jeonggubin/Industrial-Patrol-Robot-based-on-SLAM-and-CAN-Network/README.md

# Industrial Patrol Robot based on SLAM and CAN Network
SLAM 및 CAN 네트워크 기반 산업용 순찰 로봇

<table>
    <td align="center">
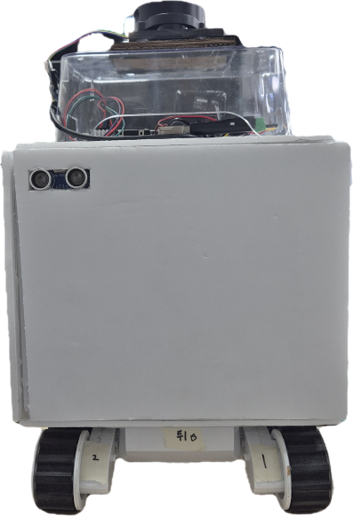
[picture p1: images/로봇후면부.png]
로봇 후면부
      
    </td>
    <td align="center">
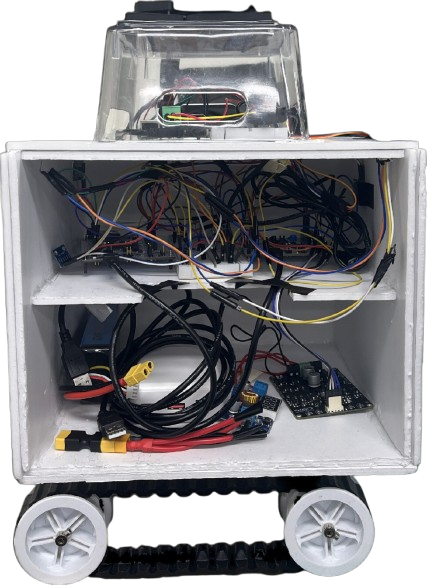
[picture p2: images/로봇내부.png]
로봇 내부
      
    </td>
    <td align="center">
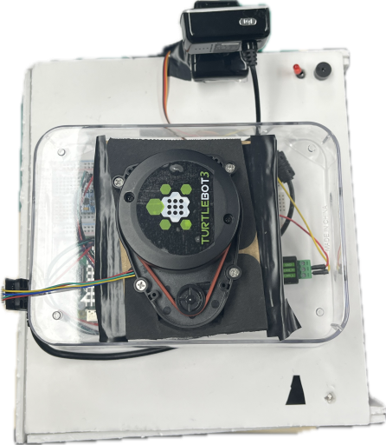
[picture p3: images/로봇상부.png]
로봇 상부
       
    </td>
  </tr>
</table>

## 🛰️ Industrial-Safety-Patrol-Mini-Project

### 🛠 개발 배경
<table>
  <tr>
    <td>
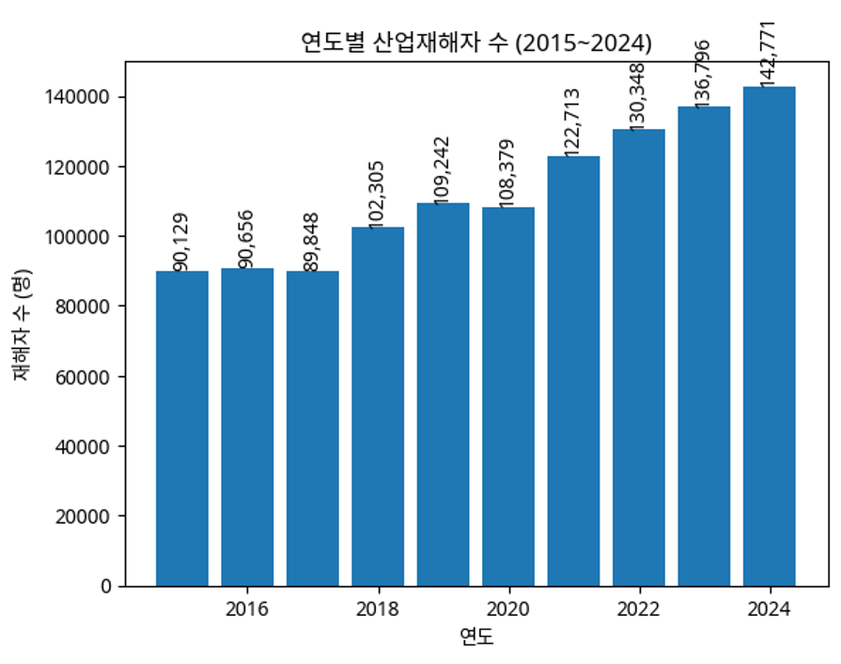
[picture p4: images/연도별 산업재해자 그래프.png]
연도별 산업재해자 그래프
      
    </td>
    <td>
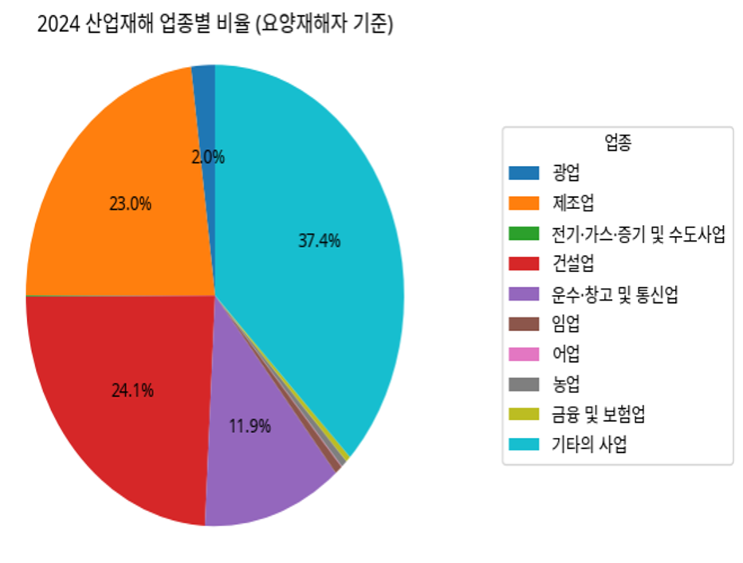
[picture p5: images/산업재해 업종별 비율 그래프.png]
산업재해 업종별 비율 그래프
      
    </td>
  </tr>
</table>

국가데이터처 ‘산업재해 현황분석’에 따르면 산업재해자 수는 매년 증가하는 추세이며, 특히 건설업과 제조업에서 높은 비율을 차지하는 것으로 나타났습니다.

이러한 산업 현장의 안전 문제와 인력 중심 현장 감시 체계의 한계를 해결하기 위해, LiDAR 기반 SLAM과 YOLOv5 비전 기술을 결합한 자율 순찰 로봇 시스템을 개발했습니다. 

본 프로젝트는 작업자의 안전장구 착용 여부를 실시간으로 감지하여 사고를 사전에 예방하고, 상시 감시 체계를 구축함으로써 현장 안전 관리의 효율성을 극대화하는 것을 목표로 합니다.

---

## 📅 프로젝트 개요
- **프로젝트 명:** SLAM 및 CAN 네트워크 기반 산업용 순찰 로봇
- **수행 기간:** 2026.02.25 ~ 2026.03.10
- **주요 기능**
  - **1:** LIDAR 기반 자율 순찰 및 SLAM
  - **2:** YOLOv5nu 기반 실시간 안전장비 탐지
  - **3:** CAN Bus 기반 분산 제어 시스템
  - **4:** 지능형 안전 정지 및 센서 데이터 필터링
  - **5:** 실시간 웹 통합 관제 대시보드
  - **6:** 자동 환경 반응 조명 및 경보 시스템

---

## 🛠 기술 스택
| 분류 | 기술 Stack |
| :--- | :--- |
| **Languages** | C, Python, JavaScript |
| **Communication** | CAN, RTSP, UDP, Socket.IO |
| **Frameworks** | ROS2 (Navi2, Cartographer, rf2o), YOLOv5nu, OpenCV, PyTorch, Node.js, MediaMTX |
| **Hardware/OS** | Raspberry Pi 5, STM32 (F446RE, F429ZI), USB-CAN 트랜시버(SN65HVD230), LiDAR(LD08), Webcam, IMU(MPU6050), Ubuntu 24.04, STM32CubeMX |

---

## 📂 디렉토리 구조
. <br>
├── 📂 **[ai_vision/](./ai_vision)** <br>
│&nbsp;&nbsp;&nbsp;└── AI 비전 기반 객체 인식 및 안전장비 착용 판별 코드 <br>
├── 📂 **[images/](./images)** <br>
│&nbsp;&nbsp;&nbsp;└── 🖼 <br>
├── 📂 **[main/](./main)** <br>
│&nbsp;&nbsp;&nbsp;└── 전체 시스템 실행 및 통합 제어 코드 <br>
├── 📂 **[slam/](./slam)** <br>
│&nbsp;&nbsp;&nbsp;└── SLAM 기반 지도 생성 및 위치 인식 관련 코드 <br>
├── 📂 **[stm32f429zi/](./stm32f429zi)** <br>
│&nbsp;&nbsp;&nbsp;└── STM32F429ZI 기반 펌웨어 프로젝트 <br>
├── 📂 **[stm32f446/](./stm32f446)** <br>
│&nbsp;&nbsp;&nbsp;└── STM32F446 기반 펌웨어 프로젝트 <br>
├── 📂 **[webDashBoard + sever/](./webDashBoard%20%2B%20sever)** <br>
│&nbsp;&nbsp;&nbsp;└── 웹 대시보드 및 서버 연동 코드 <br>
└── 📄 **[README.md](./README.md)** <br>

---

## 🧩 시스템 구성도 및 동작 흐름
- 시스템 구성도
<p align="center">
  <a href="./images/전체시스템구성도.png">
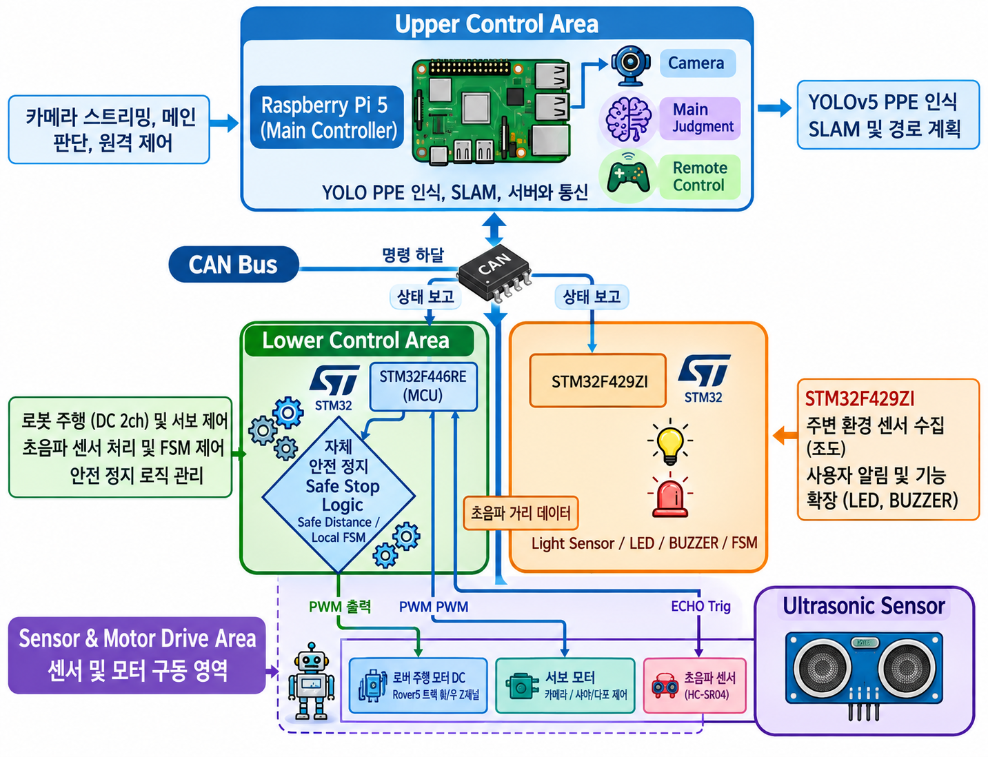
[picture p6: images/전체시스템구성도.png]
시스템 구성도
    
  </a>
</p>

- 전체 동작 흐름
```text
카메라 / LiDAR / 센서
        ↓
Raspberry Pi 5
- Vision AI
- SLAM
- 자율주행 판단
- 웹 서버
        ↓
CAN Network
        ↓
STM32 제어 노드
- 모터 제어
- 서보 제어
- 초음파 안전 정지
- LED / 부저 제어
        ↓
로버 주행 및 경고 동작
```

## 🔍 상세 기능 설명

### 1. 자율 주행 및 SLAM

로봇은 LiDAR 기반 SLAM을 이용해 작업장 지도를 생성하고, 자신의 위치를 추정하며 자율 주행을 수행합니다.

<table border="0">
  <tr>
    <td align="center">
      <a href="images/slam기반지도생성.png">
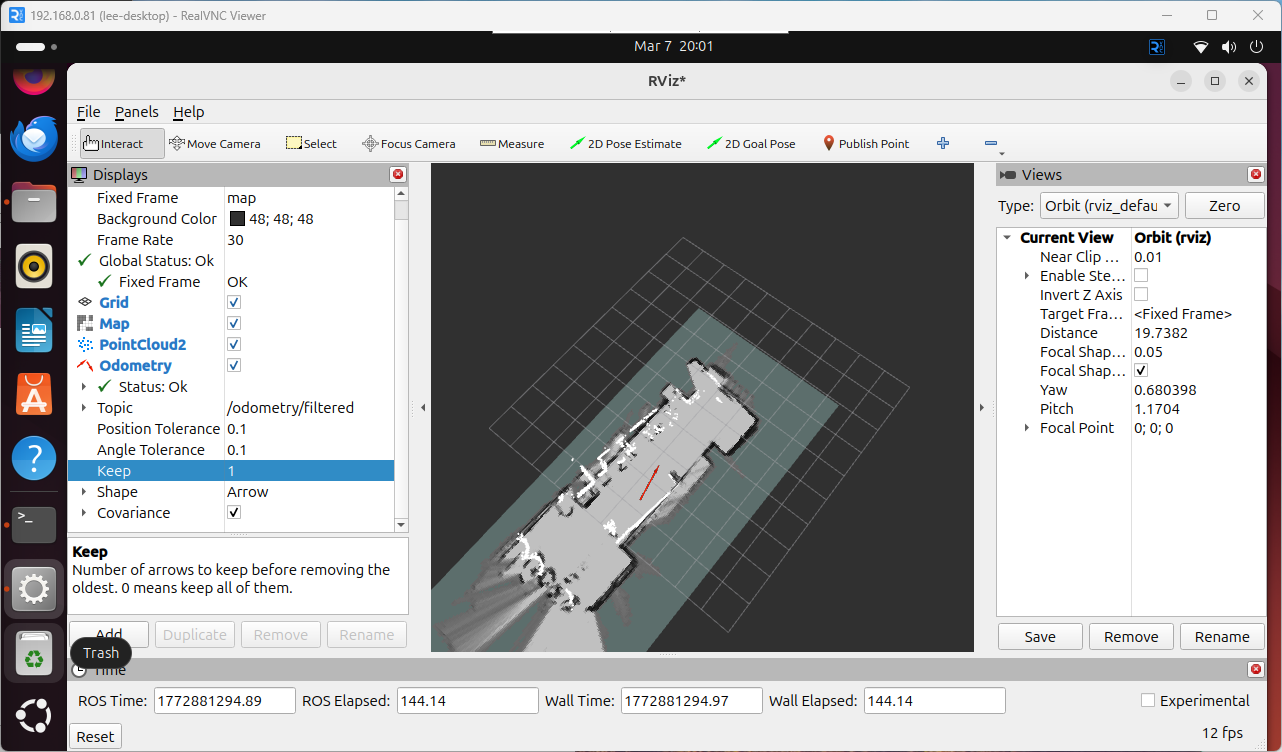
[picture p7: images/slam기반지도생성.png]
        
      </a>
    </td>
    <td align="center">
      <a href="images/자율주행_로봇+지도.png">
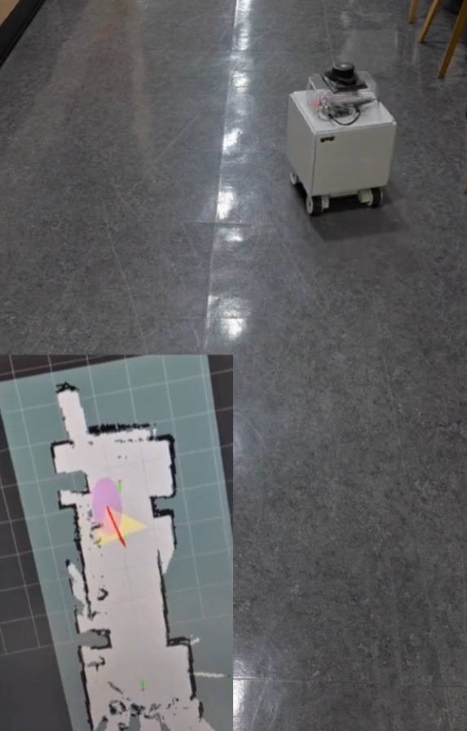
[picture p8: images/자율주행_로봇+지도.png]
        
      </a>
    </td>
    <td align="center">
      <a href="images/tftree.png">
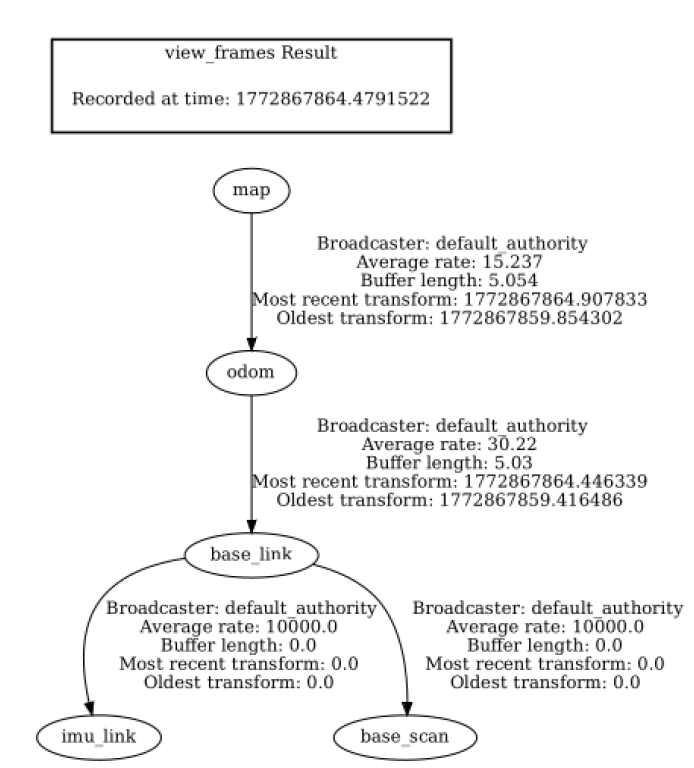
[picture p9: images/tftree.png]
        
      </a>
    </td>
  </tr>
</table>

- Cartographer SLAM 기반 지도 생성
- Nav2 기반 자율 주행
- LiDAR기반의 RF2O로 가상 오도메트리 생성
- IMU센서로 오도메트리를 보정하여 TF tree 구성 

### 2. Vision AI 안전 감지

Raspberry Pi 5에서 카메라 영상을 처리하고, YOLOv5nu 모델을 이용해 작업자를 인식합니다.  
안전모 또는 안전조끼 미착용이 감지되면 경고 신호를 제어부로 전달하여 모터를 정지시킵니다.

<div align="center">
  <video 
    src="https://github.com/user-attachments/assets/fe3a2b6f-3024-43d0-969e-007420c52cba" 
    width="80%" 
    autoplay 
    loop 
    muted 
    playsinline 
    preload="auto">
  </video>
  <p><i>실시간 안전 감지 및 CAN 통신 기반 모터 제어 시연</i></p>
</div>

<div align="center">
  <table border="0">
    <tr>
      <td align="center" style="border: none;">
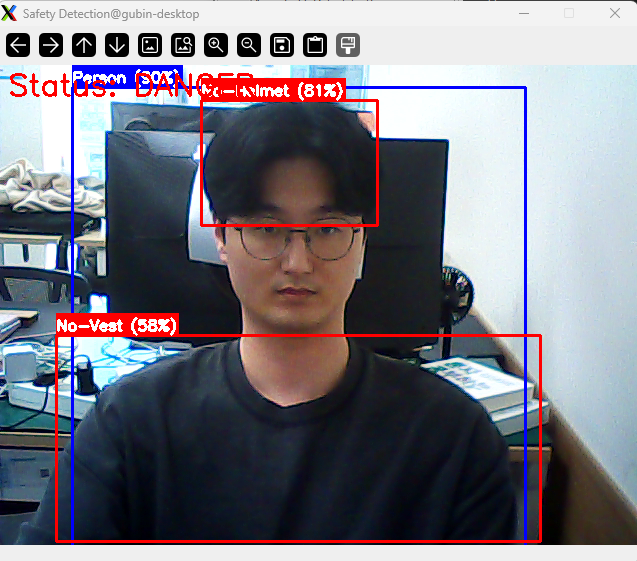
[picture p10: images/[DANGER] 모두 미착용.png]
[DANGER] 모두 미착용
        <br>
        <b>[DANGER] 모두 미착용</b>
      </td>
      <td align="center" style="border: none;">
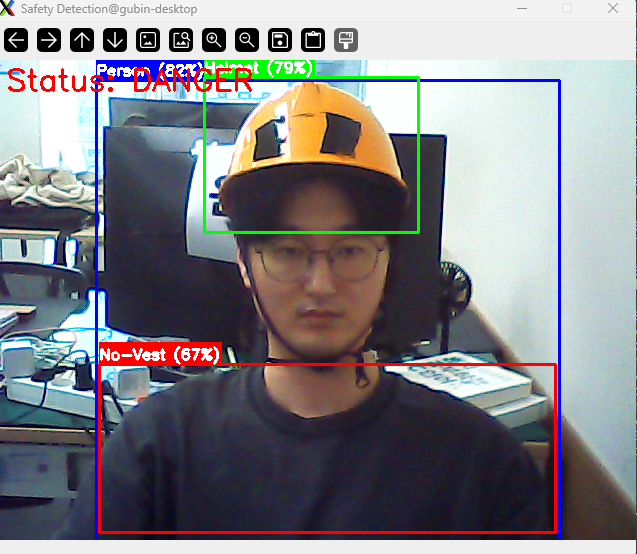
[picture p11: images/[DANGER] 안전모만 착용.png]
[DANGER] 안전모만 착용
        <br>
        <b>[DANGER] 안전모만 착용</b>
      </td>
    </tr>
    <tr>
      <td align="center" style="border: none;">
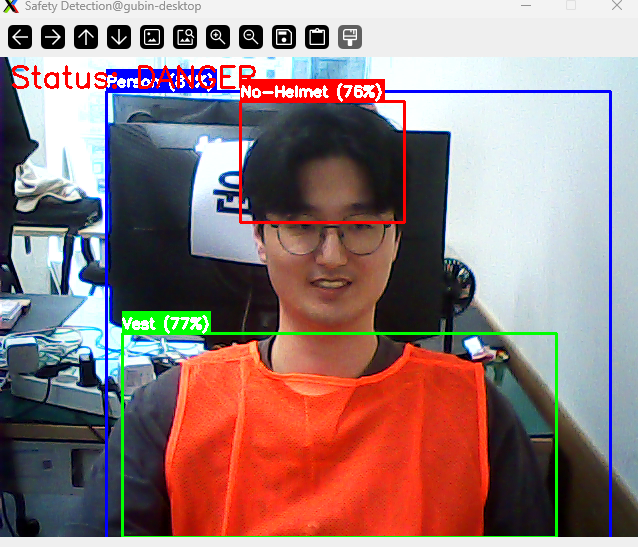
[picture p12: images/[DANGER] 안전조끼만 착용.png]
[DANGER] 안전조끼만 착용
        <br>
        <b>[DANGER] 안전조끼만 착용</b>
      </td>
      <td align="center" style="border: none;">
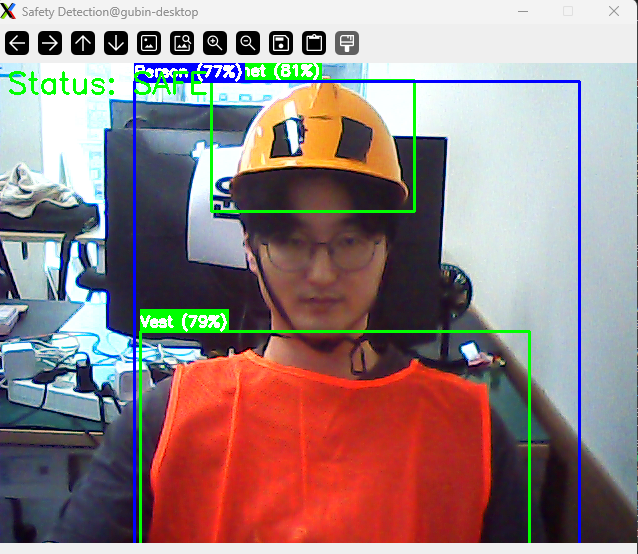
[picture p13: images/[SAFE] 모든 장비 착용.png]
[SAFE] 모든 장비 착용
        <br>
        <b>[SAFE] 모든 장비 착용</b>
      </td>
    </tr>
  </table>
</div>

### 3. CAN 기반 분산 제어 및 통신 프로토콜 📡

본 시스템은 **Raspberry Pi 5(메인 제어기)**와 **2대의 STM32 보드(하위 제어기)**를 단일 CAN 통신 버스로 연결하여 역할을 완벽히 분리하고 시스템 안정성을 높였습니다. 상위 제어기는 복잡한 연산과 네트워크를 담당하고, 하위 제어기는 실시간 하드웨어 제어를 전담합니다.

<p align="center">
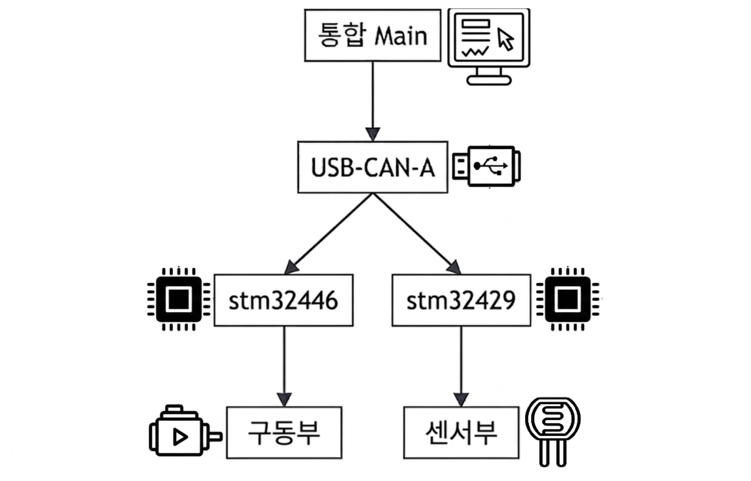
[picture p14: images/CAN_구성도.png]
CAN 네트워크 구성도
  
</p>

#### 🔹 노드별 주요 역할
| 노드 | 역할 | 상세 기능 |
|---|---|---|
| **Raspberry Pi 5** | **상위 통합 제어 및 AI** | - 자율주행 Nav2 제어 명령(`cmd_vel`)을 CAN 명령으로 변환 (`nav2_bridge`) <br>- Vision AI(YOLO) 객체 인식 및 위험 판별 <br>- WebSocket 기반 센서 데이터 웹 대시보드 송출 (`ws_client`) |
| **STM32F446RE** | **주행 및 구동계 제어** | - 좌/우 DC 모터 구동 및 카메라 서보 모터 제어 <br>- 초음파 센서 기반 긴급 제동(AEB) 독립 수행 |
| **STM32F429ZI** | **환경 센싱 및 시각적 알림** | - 조도 센서(Lux)를 통한 주변 밝기 감지 <br>- 상황별 RGB LED, 경고용 적색 LED, 부저 알림 제어 |

#### 📊 CAN 통신 메시지 ID 및 프로토콜 명세 (Data Frame)

각 노드 간의 데이터 동기화를 위해 **500kbps 속도의 CAN 분산 통신망**을 구축하였으며, 메시지 충돌을 방지하고 데이터 정밀도를 확보하기 위해 아래와 같이 데이터 ID 및 비트 패킹(Packing) 프로토콜을 독자적으로 설계하여 운영합니다.

<p align="center">
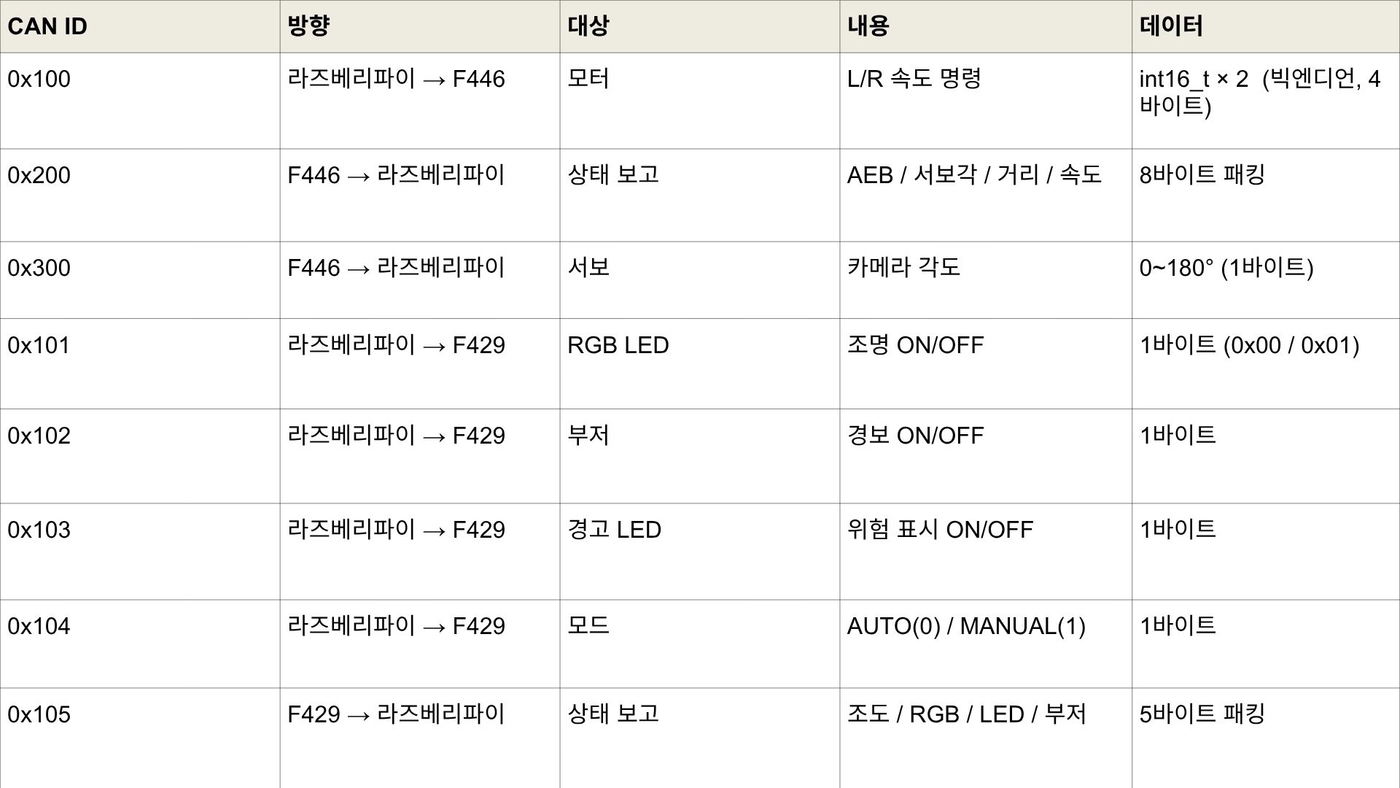
[picture p15: images/CAN 통신 메시지 ID 명세.jpg]
CAN 통신 프로토콜 명세
  
</p>

*   **모터 속도 명령 (ID: 0x100):** 데이터 왜곡 및 반전을 방지하기 위해 좌/우 속도 데이터를 int16_t 타입 2개 구조의 **빅엔디언(Big-Endian)** 방식으로 매핑하여 상위 제어기에서 주행 보드(F446)로 4바이트 전송합니다.

> ⚠️ **[이슈] CAN ID 중복 할당**
> 현재 설계 상 라즈베리파이가 STM32F446으로 보내는 모터 주행 명령 ID가 `0x100`으로 할당되어 있으나, 센서 보드인 STM32F429ZI의 헤더(`can.h`)에도 서보 제어 수신 ID가 `0x100`으로 중복 정의되어 있습니다. 프로그램 구동 시 F429 보드에도 주행 패킷이 수신될 수 있으므로, 향후 F429의 프로토콜 ID를 다른 대역으로 완전히 분리하는 작업이 필요합니다.

*   **통합 상태 보고 (ID: 0x200 / 0x105):** 하위 보드들의 독립 제어 상태(AEB 진입 유무, 초음파 거리, 현재 주행 속도 등)와 조도/알림 환경 데이터를 각각 8바이트, 5바이트로 패킹(Packing)하여 상위 관제 플랫폼으로 실시간 피드백합니다.
*   **관제 개입 및 제어권 분리 (ID: 0x104):** 원격지 관리자가 긴급 상황이나 점검 시 자율주행 판정을 수동으로 제어할 수 있도록 **AUTO(0) / MANUAL(1)** 모드 전환 인터페이스를 1바이트 구조로 설계하여 시스템 운영의 유연성을 확보했습니다.

#### 🔹 주요 통신 설계 특징
* **통합 수신 로직 처리 (`can_rx_poll`):** 두 대의 STM32가 동시에 데이터를 전송할 때 수신 버퍼 경합으로 인한 데이터 유실을 막기 위해, RPi의 메인 루프에서 최대 256회 버퍼를 일괄 소진합니다. 파싱된 데이터는 ID에 따라 별도의 정적 구조체에 저장되어 안정적으로 상태를 갱신합니다.
* **실시간 데이터 브릿지:** UDP로 수신된 자율주행 명령을 실시간으로 CAN 프레임으로 변환하여 모터로 전달하며, 반대로 CAN을 통해 수집된 로버의 하드웨어 상태 데이터는 지연 없이 WebSocket을 통해 원격 서버(대시보드)로 전송됩니다.

### 4. 구동 및 안전 정지 (STM32F446RE)

STM32F446RE는 좌/우 DC 모터와 카메라 서보를 제어합니다.  
또한 초음파 센서를 이용해 후진 중 장애물이 가까워지면 모터 출력을 자동으로 차단합니다.

- PWM 기반 좌/우 모터 제어
- Ramp 기반 부드러운 가감속
- 서보 모터 기반 카메라 각도 제어
- 초음파 센서 기반 후방 장애물 감지
- 장애물 감지 시 SAFE_ESTOP 진입

안전 정지 기준은 다음과 같습니다.

| 항목 | 기준 |
|---|---:|
| 정지 거리 | 15 cm 이하 |
| 해제 거리 | 20 cm 이상 |
| 판정 조건 | 2회 연속 감지 |

#### 🛑 제어 주기 및 안전 정지(AEB) 로직
*   **제어 주기:** 메인 루프 10ms, 초음파 트리거 60ms, 상태 CAN 송신 1000ms 주기로 동작합니다.
*   **안전 정지:** 후진 명령(좌/우 속도가 모두 음수)일 때, 초음파 거리 측정값이 **15cm 이하로 2회 연속** 잡혀 긴급 제동(SAFE_ESTOP) 상태에 진입하면 즉각적으로 모터 출력을 0으로 강제 차단합니다.
*   **정지 해제:** 측정 거리가 **20cm 이상 2회 연속** 잡힐 경우 다시 정상 주행이 가능하도록 복귀됩니다. (센서 타임아웃 200ms 초과 시에도 강제 정지 처리)
  ultrasonic_logic

### 5. 센서 수집 및 시스템 관제 (STM32F429ZI)
STM32F429ZI 보드는 방대한 GPIO 확장성을 바탕으로 시스템의 '센서 허브' 역할을 수행합니다. 다량의 작업장 환경 데이터를 병렬로 안전하게 수집하고, 시스템 경보 및 2대 보드 간 CAN 통신망을 총괄 제어합니다.

*   **하드웨어 분리 설계:** 모터 구동 시 발생하는 큰 피크 전류와 전원 노이즈가 정밀 센서 신호에 왜곡을 주지 않도록 시스템을 446(주행)과 429(센서)로 물리적 이원화하여 강인성을 확보했습니다.
*   **가청 대역 기반 경보 및 상태 출력:** 산업 현장의 소음을 극복할 수 있는 경고 시스템을 내장하고 있습니다.

| 항목 | 하드웨어 설정 값 / 제어 기준 | 비고 |
| :--- | :--- | :--- |
| **조도 샘플링 시간** | **84 사이클 (Polling Mode)** | 12비트 ADC 충전 시간 충족 (메인 루프에서 Polling 방식으로 수집) |
| **RGB LED 주파수** | **1 kHz** (PSC: 179, ARR: 999) | 사람 눈의 깜빡임 방지, Auto-reload preload 활성화로 Glitch 차단 |
| **경고 부저 주파수** | **500 Hz** (PSC: 167, ARR: 999) | APB1 타이머 클럭(84MHz) 기준 500Hz 출력 설정 (50% Duty Cycle) |
| **소모 전류 (Peak)** | 약 **200mA ~ 280mA** (서보모터 제외) | 피크 800mA인 서보모터를 446으로 분리하여 429 보드 전압 강하 방지 |

###### 💡 운영 모드 및 시스템 연동 로직
*   **수동 모드 (Manual Mode):** 원격 관제 센터의 관리자가 정밀 점검이나 특정 이미지 캡처를 수행할 때 사용자 명령대로 LED 색상과 On/Off 상태를 제어하여 운영의 유연성을 확보합니다.
*   **CAN 관제 인터페이스:** 500kbps 표준망을 통해 유입되는 긴급 명령에 따라 경고 LED와 부저를 즉각 제어하며, 수집된 모든 센서의 로우 데이터를 실시간으로 역전송하여 관제 대시보드와 동기화합니다.

> 💡 **조명 자동 제어(Auto Mode) 동작 방식**
> 라즈베리파이는 시작 시 F429를 MANUAL 모드로 설정합니다(`main/main.c`). 웹 대시보드에서 자율 주행 모드를 켜면 F429도 AUTO 모드로 전환되어, 조도 값(12비트 ADC)이 임계치 2000 미만일 때 RGB LED가 자동으로 점등됩니다. 수동 모드에서는 수동 관제 명령과 충돌하지 않도록 웹 대시보드의 조명 ON/OFF 명령으로만 제어됩니다. 조도 센서는 연속 변환 대신 메인 루프에서 200ms마다 단일 변환(Polling) 방식으로 측정합니다.

### 6. 웹 대시보드 및 서버

#### 웹 대시보드
웹 대시보드는 로봇의 상태를 실시간으로 확인하고 원격 제어하기 위한 화면입니다.
<table border="0">
  <tr>
    <td align="center">
      <a href="images/대시보드(맵).png">
        
      </a>
    </td>
    <td align="center">
      <a href="images/대시보드(수동조작).png">
        
      </a>
    </td>
  </tr>
</table>

- 실시간 카메라 영상 표시
- SLAM 맵 화면 표시
- 수동 주행 제어
- 자율 주행 모드 전환
- 조명 및 경고 장치 제어
- 모터 속도, 초음파 거리, 조도 값 표시
- 서버 및 로봇 연결 상태 표시

#### 서버(Node.js)
- 클라이언트와 로봇의 포트를 분리하여 안정성 확보 및 다중 접속 가능 설계
- 클라이언트가 접속시 별도의 앱 설치 없이 웹 대시보드 이용가능
- 맵(rviz2)과 웹캠 화면을 RTSP로 실시간 수신하여 MediaMTX로 JSMpeg로 변환
- 로봇의 상태정보와 웹 대시보드의 명령을 소켓으로 통신 인프라 구축

### 핵심 요약

이 프로젝트는 **SLAM 자율주행**, **Vision AI 안전 감지**, **CAN 기반 분산 제어**, **웹 대시보드 관제**를 통합한 작업장 순찰 로봇입니다.

---

## 🎬 시연 영상
SLAM 및 CAN 네트워크 기반 산업용 순찰 로봇 (https://youtu.be/PNa3HpqTolg?si=JT_z5yxzs2ES-m6S)

---

## ⚠️ 보완점 및 향후 과제
- **Vision AI 및 추론 성능 최적화**  
  데이터 증강을 통한 'No-Helmet' 인식률을 보강하고, YOLOv11n 업그레이드 및 Jetson Nano 도입으로 엣지 환경의 프레임 저하 문제를 개선할 예정이다.  

- **SLAM 주행 정밀도 및 신뢰성 향상**  
  기존 IMU 센서를 고정밀 고성능 센서로 교체하고 엔코더를 추가 도입하여 위치 추정(Localization)의 누적 오차를 보정하고, 장기적으로 VSLAM 전환을 통해 실시간 주행 안정성을 확보할 계획이다.  

- **CAN 통신 아키텍처 및 안전 로직 강화**  
  Heartbeat 신호를 통한 통신 유실 감지 기능을 추가하고, CAN ID 우선순위 재배치를 통해 긴급 정지(AEB) 등 안전 관련 제어의 신뢰성을 극대화할 예정이다.  

- **웹 관제 시스템 저지연 스트리밍 구현**  
  현재의 RTSP 변환 지연(1.5초)을 해결하기 위해 WebRTC 기반 스트리밍 서버를 구축하고, 관리자 간 상태 공유 및 보안 시스템을 고도화할 방침이다.

---
