jeonggubin/Industrial-Patrol-Robot-based-on-SLAM-and-CAN-Network/ai_vision/README.md

# 📂 Vision AI: 작업자 안전 장비 탐지 엔진

본 모듈은 건설 현장 내 작업자의 안전 장비(헬멧, 조끼) 착용 여부를 실시간으로 감지하고, 판단 결과에 따라 로봇의 주행을 제어 및 관제 서버로 영상을 송출하는 **YOLO 기반 시각 지능 엔진**입니다.

## 1. 데이터셋 및 학습 (Dataset & Training)

다양한 현장 환경에서도 높은 강인함(Robustness)을 유지하기 위해 데이터 증강 및 정제 과정을 거쳤습니다.

* **데이터 구성**: `Helmet`, `No-Helmet`, `No-Vest`, `Person`, `Vest` 총 5개 클래스
* **학습 전략**: 실제 현장에서 발생할 수 있는 미착용 사례 데이터를 집중 확보하여 학습 편향을 최소화했습니다.

| 데이터셋 클래스 분포 | 탐지 객체 샘플 |
| :---: | :---: |
|  |  |

---

## 2. 모델 성능 검증 (Model Performance)

임베디드 환경(Raspberry Pi 5)에서 실시간 추론이 가능하도록 최적화된 모델을 사용하였으며, 50 Epoch 학습 결과 실환경 적용에 적합한 수치를 달성했습니다.

* **mAP@0.5**: **0.978** 달성
* **성능 요약**: Precision과 Recall의 균형이 뛰어나며, 특히 작업자(Person)와 헬멧(Helmet) 탐지에서 98% 이상의 정확도를 확보했습니다.

### 📈 학습 결과 지표

| Precision-Recall Curve | Loss & Metrics 추이 |
| :---: | :---: |
|  |  |

---
## 3. 성능 튜닝 및 오탐지 완화

라즈베리파이 환경에서의 실시간성을 확보하고 시스템 신뢰도를 높이기 위해 다음과 같은 최적화 기법을 적용했습니다.

### ⚡ 연산 효율화 (Frame Skipping)
라즈베리파이의 CPU 부하를 최적화하기 위해 모든 프레임을 추론하지 않고, 3프레임마다 1번씩 연산을 수행하여 프레임 저하를 완화하고 안정적으로 약 15FPS 유지.
```python
PROCESS_EVERY_N = 3  # 3프레임당 1회 추론 수행
```

### 🛡️ 지능형 경보 필터링 (1.5s Trigger Delay)

순간적인 오탐지(False Positive)로 인한 빈번한 경보를 방지하기 위해, 위험 상태가 **1.5초 이상 지속**될 경우에만 최종 위험(`DANGER`) 상태로 확정하고 UDP 신호를 전송합니다.
```python
TRIGGER_DELAY = 1.5  # 상태 확정 지연 시간(초)

# 상태 유지 시간 계산 및 확정 로직

if (time.time() - state_start_time) >= TRIGGER_DELAY:

    confirmed_flag = current_raw_danger

    send_udp(confirmed_flag)
```

## 4. 실시간 데이터 송출 및 통신 (Integration)

AI 판단 결과를 로봇 제어부와 관제 센터로 전달하기 위해 두 가지 통신 방식을 병행하여 시스템을 통합했습니다.

* **⚡ UDP 기반 초저지연 경보 전송**
    * 판단 결과(`SAFE`/`DANGER`)를 `127.0.0.1:9999`로 전송하여 하위 제어기(STM32) 또는 메인 로직이 즉각적으로 반응할 수 있도록 설계했습니다.
    * **Non-blocking 소켓**을 사용하여 네트워크 지연이 전체 AI 추론 루프(Main Loop)에 영향을 주지 않는 비동기 구조를 구현했습니다.

* **🎥 FFmpeg 기반 RTSP 스트리밍**

| RTSP 스트리밍 | 실시간 데이터 송출 로그 |
| :---: | :---: |
|  |  |

* OpenCV로 처리된 시각화 프레임을 `libx264` 코덱으로 압축하여 외부 RTSP 서버로 송출합니다.
* `ultrafast` 프리셋과 `zerolatency` 튜닝을 적용하여, 관제 센터에서 현장 상황을 실시간(Real-time)으로 모니터링할 수 있는 저지연 스트리밍 환경을 구축했습니다.

## 5. 주요 구현 기술 (Technical Implementation)

임베디드 환경에서의 효율적인 연산과 정확도 확보를 위해 적용한 핵심 기술 스택입니다.

* **🚀 ONNX Runtime 활용**
    * 학습된 PyTorch 모델을 **ONNX 형식으로 변환**하여 라즈베리파이 5 CPU 환경에서 추론 속도를 극대화했습니다.
* **🖼️ Letterbox 전처리:** 640x480 비율의 카메라 입력 프레임을 YOLO 모델의 기본 입력 규격에 맞춰 640x640 해상도로 패딩(Padding)하는 전처리를 통해, 다양한 카메라 각도에서도 탐지 강인함을 유지했습니다.
* **🎯 다중 클래스 NMS (Non-Maximum Suppression)**
    * 클래스별 **오프셋(Offset) 로직**을 적용하여, 작업자(Person)와 안전 장비(Helmet/Vest)가 겹쳐 있는 복잡한 상황에서도 박스 손실 없이 개별 객체를 정확하게 분리 탐지합니다.
