jeonggubin/Industrial-Patrol-Robot-based-on-SLAM-and-CAN-Network/webDashBoard + sever/server/README.md

# site_inspection_robot
현장을 돌아다니며 감독 감시하는 로봇
