jeonggubin/Industrial-Patrol-Robot-based-on-SLAM-and-CAN-Network/images/로봇전면부.png

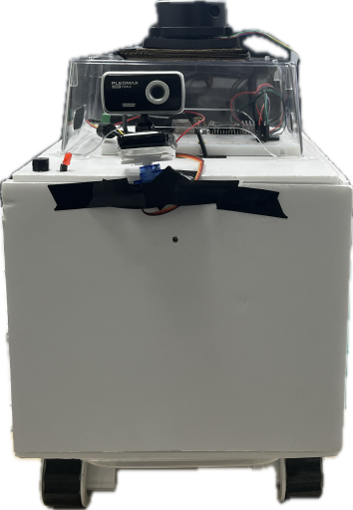
images/로봇전면부.png
