jeonggubin/Industrial-Patrol-Robot-based-on-SLAM-and-CAN-Network/stm32f446/Core/Src/main.c

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
/* Includes ------------------------------------------------------------------*/
#include "main.h"

/* USER CODE BEGIN Includes */
#include "ap.h"
#include "can_comm.h"
#include "stm32f4xx_hal.h"

/* USER CODE END Includes */

CAN_HandleTypeDef hcan1;

TIM_HandleTypeDef htim2;
TIM_HandleTypeDef htim3;
TIM_HandleTypeDef htim4;

UART_HandleTypeDef huart2;

void SystemClock_Config(void);
static void MX_GPIO_Init(void);
static void MX_TIM2_Init(void);
static void MX_USART2_UART_Init(void);
static void MX_TIM3_Init(void);
static void MX_CAN1_Init(void);
static void MX_TIM4_Init(void);
/**
  * @brief  The application entry point.
  * @retval int
  */
int main(void)
{

  /* MCU Configuration--------------------------------------------------------*/

  /* Reset of all peripherals, Initializes the Flash interface and the Systick. */
  HAL_Init();

  /* Configure the system clock */
  SystemClock_Config();

  /* Initialize all configured peripherals */
  MX_GPIO_Init();
  MX_TIM2_Init();
  MX_USART2_UART_Init();
  MX_TIM3_Init();
  MX_CAN1_Init();
  MX_TIM4_Init();
  /* USER CODE BEGIN 2 */
  // hwInit();
  apInit();
  // apMain();
  /* USER CODE END 2 */

  /* Infinite loop */
  /* USER CODE BEGIN WHILE */
  while (1) {
    /* USER CODE END WHILE */

    /* USER CODE BEGIN 3 */
    apMain();
    // HAL_Delay(10);
  }
  /* USER CODE END 3 */
}

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
/* USER CODE BEGIN 4 */
void HAL_TIM_IC_CaptureCallback(TIM_HandleTypeDef *htim) {
  apUltrasonic_OnCapture(htim);
}

/**
 * @brief  CAN 수신 인터럽트 콜백
 * @param  hcan: CAN 핸들러
 */
void HAL_CAN_RxFifo0MsgPendingCallback(CAN_HandleTypeDef *hcan) {
  can_comm_rx_handler(hcan);
}

void HAL_CAN_ErrorCallback(CAN_HandleTypeDef *hcan) {
  if (hcan->ErrorCode & HAL_CAN_ERROR_BOF) {
    HAL_CAN_Stop(hcan);
    HAL_CAN_Start(hcan);
    can_comm_restart();
  }
}

void HAL_GPIO_EXTI_Callback(uint16_t GPIO_Pin) {
  if (GPIO_Pin == B1_Pin) {
    can_comm_restart();
  }
}

/* USER CODE END 4 */
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
