jeonggubin/Industrial-Patrol-Robot-based-on-SLAM-and-CAN-Network/stm32f446/stm32f446.ioc

Mcu.UserName=STM32F446RETx
PA0-WKUP.GPIO_Label=ECHO_ultrasonic
PA0-WKUP.Signal=S_TIM2_CH1_ETR
PA11.Signal=CAN1_RX
PA12.Signal=CAN1_TX
PA13.GPIO_Label=TMS
PA13.Signal=SYS_JTMS-SWDIO
PA14.GPIO_Label=TCK
PA14.Signal=SYS_JTCK-SWCLK
PA2.GPIO_Label=USART_TX
PA2.Signal=USART2_TX
PA3.GPIO_Label=USART_RX
PA3.Signal=USART2_RX
PA5.GPIO_Label=LD2 [Green Led]
PA5.Signal=GPIO_Output
PA6.GPIO_Label=PWM1_rover
PA6.Signal=S_TIM3_CH1
PA7.GPIO_Label=PWM2_rover
PA7.Signal=S_TIM3_CH2
PA8.GPIO_Label=DIR1_rover
PA8.Signal=GPIO_Output
PA9.GPIO_Label=DIR2_rover
PA9.Signal=GPIO_Output
PB1.GPIO_Label=TRIG_ultrasonic
PB1.Signal=GPIO_Output
PB3.GPIO_Label=SWO
PB3.Signal=SYS_JTDO-SWO
PB6.GPIO_Label=servoPWM
PB6.Signal=S_TIM4_CH1
PC13.GPIO_Label=B1 [Blue PushButton]
PC13.Signal=GPXTI13
PC14-OSC32_IN.Signal=RCC_OSC32_IN
PC15-OSC32_OUT.Signal=RCC_OSC32_OUT
PH0-OSC_IN.Signal=RCC_OSC_IN
PH1-OSC_OUT.Signal=RCC_OSC_OUT
