jeonggubin/Industrial-Patrol-Robot-based-on-SLAM-and-CAN-Network/stm32f446/Core/Inc/main.h

#define B1_Pin GPIO_PIN_13
#define B1_GPIO_Port GPIOC
#define ECHO_ultrasonic_Pin GPIO_PIN_0
#define ECHO_ultrasonic_GPIO_Port GPIOA
#define USART_TX_Pin GPIO_PIN_2
#define USART_TX_GPIO_Port GPIOA
#define USART_RX_Pin GPIO_PIN_3
#define USART_RX_GPIO_Port GPIOA
#define LD2_Pin GPIO_PIN_5
#define LD2_GPIO_Port GPIOA
#define PWM1_rover_Pin GPIO_PIN_6
#define PWM1_rover_GPIO_Port GPIOA
#define PWM2_rover_Pin GPIO_PIN_7
#define PWM2_rover_GPIO_Port GPIOA
#define TRIG_ultrasonic_Pin GPIO_PIN_1
#define TRIG_ultrasonic_GPIO_Port GPIOB
#define DIR1_rover_Pin GPIO_PIN_8
#define DIR1_rover_GPIO_Port GPIOA
#define DIR2_rover_Pin GPIO_PIN_9
#define DIR2_rover_GPIO_Port GPIOA
#define TMS_Pin GPIO_PIN_13
#define TMS_GPIO_Port GPIOA
#define TCK_Pin GPIO_PIN_14
#define TCK_GPIO_Port GPIOA
#define SWO_Pin GPIO_PIN_3
#define SWO_GPIO_Port GPIOB
#define servoPWM_Pin GPIO_PIN_6
#define servoPWM_GPIO_Port GPIOB
