jeonggubin/Industrial-Patrol-Robot-based-on-SLAM-and-CAN-Network/(commit log)

2026-03-22 slam 기반 자율주행 코드
2026-03-22 STM32F446 프로젝트 소스 코드 추가
2026-05-13 main 코드 설명 추가
2026-05-24 Update README to include video demonstration
    Replaced image with video demonstration of real-time safety detection and motor control.
2026-05-25 robot_can.c 주석 설명 수정
2026-05-30 Revise system architecture and flow details
    Updated system architecture and flow description in README.
2026-11-12 docs: README 내용을 실제 코드와 일치하도록 수정
    - AEB 적용 조건(후진 시에만) 정정
    - F429 Auto Mode 동작 방식 정정
    - F429 부저/ADC 설정값 및 구조도 정정
    - LiDAR 모델(LD08), 브릿지 노드 파일명 정정
    - 오타 수정
    Claude-Session: https://claude.ai/code/session_019eYTwRL4FpkaRWLQnn9zdc
