jeonggubin/Industrial-Patrol-Robot-based-on-SLAM-and-CAN-Network/(notices)

Notices in the files:
stm32f446/Core/Inc/main.h:
Copyright (c) 2026 STMicroelectronics.
All rights reserved.
This software is licensed under terms that can be found in the LICENSE file
